Burgestrand/twitterskylt/README.md

# Twitterskylt

## Kloning

    git clone --recursive git://github.com/Burgestrand/twitterskylt.git
    cd twitterskylt

## Hämtning av HTTP-parser

    git submodule update --init
