Burgestrand/twitterskylt/Sign/Sign.ino

#include <avr/interrupt.h>
#include <stdlib.h> // XXX For testing purposes
#include <string.h> // XXX For testing purposes
#include <XBee.h>
#include <SoftwareSerial.h>
#include <EndDevice.h>
#include <avr/pgmspace.h>
//#include <SPI.h>
//#include <Display.h>
#include <LiquidCrystal.h>
#include <DisplaySmall.h>
#include <Sleep.h>

// TODO: 
// Radio error handling
// Use leds properly

// The maximum size of a message from the base station
// including date, nullbyte, hyphens, twitter message
// and newlines.
#define MAX_MSG_SIZE 168

// Common constants:
// Constants related to battery level reading
#define V_RES 0.004882814
#define V_TH 0.7
#define V_LOW 3.3
#define Q_DROP 408

// Display related
#define DISPLAY_SELECT_PIN 10
#define DISPLAY_BUSY_PIN 8
#define DISPLAY_RESET_PIN 9

// Small display related
#define DISPLAY_SMALL_E 13
#define DISPLAY_SMALL_RSC 12
#define DISPLAY_SMALL_DATA 8

// XBee sleep request/status
#define SLEEP_RQ_PIN 4
#define SLEEP_STATUS_PIN 5

// Real hardware constans

// Join Button
#define JOIN_BUTTON 2
// Update Button
#define UPDATE_BUTTON 3
// Red LED
#define ERROR_LED A3
// Yellow LED
#define BATTERY_LED A2
// Green LED
#define ASSOC_LED A1
// Analog battery reading
#define BATT_A A0
//Voltage divider control
#define VDIV_D 6
// XBee CTS Pin
#define CTS_PIN 7

// Common global variables
// The display
//Display disp(DISPLAY_SELECT_PIN, DISPLAY_BUSY_PIN, DISPLAY_RESET_PIN); // For the KENT display, RIP.
DisplaySmall disp(DISPLAY_SMALL_RSC, DISPLAY_SMALL_E, DISPLAY_SMALL_DATA, DISPLAY_SMALL_DATA + 1, DISPLAY_SMALL_DATA + 2, DISPLAY_SMALL_DATA + 3);

// The radio
EndDevice radio(SLEEP_RQ_PIN, SLEEP_STATUS_PIN);
//
// True if the join button has been pressed, but not yet handled
volatile bool joinPressed = false;

// True if the update button has been pressed, but not yet handled
volatile bool updatePressed = false;

// Store old message to be able to notice when a message fetched from the base station is actually new.
char message[MAX_MSG_SIZE] = {0};
// True if a new message has been received, and should be printed.
bool new_msg = false;

// ISR for handling join button presses
void joinButtonPressed(void) {
  joinPressed = true;
}

// ISR for handling update button presses
void updateButtonPressed(void) {
  updatePressed = true;
}

void invalidate_data(void) {
  message[0] = 0;
  new_msg = false;
}

// True if the battery level is low
bool lowBattery = false;
// Analog value read from voltage divider
float batteryLevel = 0;

// Dummy debug function.
void debug(char *msg) { }

float getPinVoltage(uint8_t pin) {
	return (analogRead(pin) * V_RES);
}

float getBatteryVoltage(uint8_t pin) {
  // Voltage divider divides voltage by 2
  // Value from analog port has resolution of 49mV (5V/1024)
  // Also adjusts for voltage drop across MOSFET (approximation)
  int batteryLevel = analogRead(0);
  float Vbatt = (2*batteryLevel*V_RES) - 0.04*(batteryLevel/Q_DROP);
  return Vbatt;
}

// XXX Output message length and current time (as given by millis, truncated to
// 16 bits) to display. For testing packet-loss with the small display.
void output_msg(char *msg) {
	char lenbuf[4];
	char timebuf[7];
	char buf[34];

	itoa(strlen(msg), lenbuf, 10);
	itoa((uint16_t) millis(), timebuf, 10);

	strcpy(buf, "MSGLEN: ");
	strcat(buf, lenbuf);
	strcat(buf, "\nTID: ");
	strcat(buf, timebuf);

	disp.write(buf);
}

// Usual arduino functions
void setup () {
  pinMode(ASSOC_LED, OUTPUT);
  digitalWrite(ASSOC_LED, LOW);
  pinMode(ERROR_LED, OUTPUT);
  digitalWrite(ERROR_LED, LOW);
  pinMode(BATTERY_LED, OUTPUT);
  digitalWrite(ERROR_LED, LOW);

  pinMode(VDIV_D, OUTPUT);
  digitalWrite(VDIV_D, LOW);
  pinMode(BATT_A, INPUT);


  // Initialize the display
  //disp.begin();  // begin call for the KENT display
  disp.begin(16, 2);
  
  // Initialize the radio
  radio.begin(9600);
  
  // Initialize the sleep timer
  sleep_begin();
  
  // Setup the buttons
  attachInterrupt(0, joinButtonPressed, FALLING);
  attachInterrupt(1, updateButtonPressed, FALLING);

  // Show that we're done initializing
  disp.write("Initialized");

}

void loop () {
  // Handle button presses
  // Pair button
  if (joinPressed) {
    joinPressed = false;
    digitalWrite(ERROR_LED, LOW);
    digitalWrite(ASSOC_LED, LOW);
    debug("JOINBTN NOTICED");
    disp.write("Trying to join\nnetwork");
    invalidate_data();
    radio.joinNetwork();
  }
  
  digitalWrite(VDIV_D, HIGH);
  batteryLevel = getBatteryVoltage(BATT_A);
  delay(1);
  digitalWrite(BATTERY_LED, (batteryLevel <= V_LOW ? HIGH : LOW));
  
  // Necessary for the radio library to work
  switch (radio.tick()) {
    case TICK_ASSOC_FAIL:
      // Association failed (note: not pairing)
      invalidate_data();
      disp.write("Assoc fail");
      digitalWrite(ERROR_LED, HIGH);
      digitalWrite(ASSOC_LED, LOW);
      break;
    case TICK_JOIN_NOT_DELIVERED:
      // Could not deliver join message
      invalidate_data();
      disp.write("Join:\n No delivery");
      digitalWrite(ERROR_LED, HIGH);
      digitalWrite(ASSOC_LED, LOW);
      break;
    case TICK_JOIN_TIMEOUT:
      invalidate_data();
      disp.write("Join:\n Timeout");
      digitalWrite(ERROR_LED, HIGH);
      digitalWrite(ASSOC_LED, LOW);
      break;
    case TICK_JOIN_OK:
      invalidate_data();
      disp.write("Joined!");
      digitalWrite(ASSOC_LED, HIGH);
      break;
    case TICK_UPDATE_NO_DELIVERY:
      invalidate_data();
      disp.write("Update:\n No delivery");
      digitalWrite(ERROR_LED, HIGH);
      digitalWrite(ASSOC_LED, LOW);
      break;
    case TICK_UPDATE_TIMEOUT:
      invalidate_data();
      disp.write("Update:\n Timeout");
      digitalWrite(ERROR_LED, HIGH);
      digitalWrite(ASSOC_LED, LOW);
      break;
    case TICK_NEW_MSG:
      // Update message buffer if a different message is recieved and set a flag.
      // We can't update the display here as it will block for some non-insignificant time.
      debug("GOT A MSG");
      if (strncmp(message, (char *) radio.getData(), MAX_MSG_SIZE-1)) {
          debug("GOT A NEW MSG");
          strncpy(message, (char *) radio.getData(), MAX_MSG_SIZE-1);
          new_msg = true;
      }
      break;
    case TICK_SLEEPING:
      // Send the new message to the display if there is one.
      // The blocking write operation is safe here as the radio is sleeping.
      if (new_msg) {
          debug("PRINTING MESSAGE");
          disp.write(message);
          // XXX For testing purposes.
          // output_msg(message);
          new_msg = false;
      }
      // Radio is sleeping and we have nothing to do; lets sleep!
      {
        uint8_t sleepRounds = 3;
        // Sleep until we've sleept long enough or a button has been pressed.
        while (sleepRounds-- && !joinPressed && !updatePressed) {
          sleep();
        }
      }
      // If the join button was pressed we shouldn't update the message.
      if (!joinPressed) {
        radio.getNewestMessage();
      }
      updatePressed = false;
      break;
    case TICK_UNKNOWN_ERROR:
    case TICK_JOIN_BAD_MSG:
      invalidate_data();
      digitalWrite(ERROR_LED, HIGH);
      digitalWrite(ASSOC_LED, LOW);
      break;
    case TICK_OK:
    default:
      // Do nothing
      break;
  }
}

// Watchdog is only for waking the microcontroller, so the body is empty.
EMPTY_INTERRUPT(WDT_vect)
