Burgestrand/twitterskylt/(commit log)

2012-01-22 Make the makefile… SMARTER
2012-02-08 Added simple function for simulating printing of characters on 40x4 display.
2012-02-08 Added Jasmine test framework and empty specification.
2012-02-11 Added text file with 100 sample tweets.
2012-02-11 Commit a justify prototype in C
2012-02-15 Adding sleep library, containing powersave functions (unfinished)
2012-02-15 Use watchdog timer as sleep timer.
2012-02-16 Adding timer class
2012-02-19 Add arduino_helpers
2012-02-23 Removing serial debug printouts, changing response data return
2012-02-29 Replace date formatting code with Arduino-compatible code.
2012-03-01 Fix capitalization of enddevice in EndDevice.cpp.
    [EndDevice.cpp]
2012-03-01 Changing file structure to match Arduino libraries
2012-03-01 Correct forming should work.
    [EndDevice.cpp]
2012-03-14 Add test versions of HTTP request and JSON parsing on Arduino.
2012-03-14 Quick bugfix. Should compile fine for Arduino now as well
2012-03-14 Some minor fixes. Compiles and uploads to Arduino.
2012-03-16 Implement multi package messages in end device.
2012-03-18 Fix include path in Base/Sign
    [Base.ino, Sign.ino]
2012-03-20 fixed some returns and structure
    [Dhcp.cpp, Dhcp.h, Ethernet.cpp]
2012-03-20 Add Arduino-adapted formatting code and remove old formatting code.
2012-03-30 Fix some include paths.
    [Display.h, EndDevice.h]
2012-04-16 Add sign sketch, fix compilation bug with sleep status/request pins in EndDevice, add some comments.
    [EndDevice.cpp, EndDevice.h, Sign.ino]
2012-04-16 Better handling of update button on the sign.
2012-04-16 Add missing state change in EndDevice.
    [EndDevice.cpp]
2012-04-17 Reset flags/timers when joining a new network in EndDevice.
    [EndDevice.cpp]
2012-04-19 added errormsg and parsing
    [Base.ino]
2012-04-22 Update pin configuration in sign sketch.
2012-04-23 fixed definition of _build_query(), fixes #18
    [HTTP.cpp, HTTP.h]
2012-04-24 Fix font index offset bug.
    [Display.cpp]
2012-04-24 Avoid writing to top frame in Display library.
    [Display.cpp]
2012-04-24 added missing state in tick()
    [HTTP.cpp]
2012-04-30 fixed timezone fetching and parsing
    [Base.ino]
2012-05-04 Finish first prototype of report
2012-05-04 Reset timeout counter when complete message is received.
    [EndDevice.cpp, Sign.ino]
2012-05-04 Add slight delay before checking busy pin on the display to avoid race conditions.
    [Display.cpp]
2012-05-04 Move LEDs to analog I/O pins to make room for XBee Sleep and Sleep_RQ pins
2012-05-04 Add CTS pin for XBee
2012-05-05 Both LED's will be active on startup.
2012-05-08 Remove compilation error typo.
    [Sign.ino]
2012-05-09 Remove potential missed packets bug from EndDevice library.
    [EndDevice.cpp]
2012-05-09 Add library link for new old Display library, fix compilation errors.
    [Sign.ino]
2012-05-11 Add a couple of sources
2012-05-14 Update sign flow-chart.
2012-05-14 Turn off sign error led when joining a new network.
    [Sign.ino]
2012-05-14 Turn off sign assoc led when joining new network.
2012-05-14 Correcter behaviour of the assoc led.
    [Sign.ino]
